vincentfusco/tt06_555/docs/info.md

<!---

This file is used to generate your project datasheet. Please fill in the information below and delete any unused
sections.

You can also include images in this folder and reference them in the markdown. Each image must be less than
512 kb in size, and the combined size of all images must be less than 1 MB.
-->

## How it works

It duplicates the functionality of a 555 timer. Try configuring it in the "astable" configuration using external resistors and capacitors.

## How to test

Find a 555 timer datasheet and attempt some of the suggested circuits. 

Connect pins to a breadboard with jumper wire. 

Construct circuit shown in Figure 7-5 at: https://www.ti.com/lit/ds/symlink/lmc555.pdf?ts=1711738020668.

Test 2:

Duplicate circuit in Figure 6-2 at: https://www.ti.com/lit/ds/symlink/lmc555.pdf?ts=1711738020668. Compare resulting maximum frequency. The CMOS-based TI 555-Timer has a maximum frequency of 3.0MHz. Compare.

## External hardware

1. Wires for breadboard.
2. Through-hole resistors and capacitors of various values, LEDs, etc.
3. Breadboard.
4. Oscilloscope (for maximum frequency test)
