vincentfusco/tt06_555/docs/COMP_P.md

## Comparator Design Notes ##

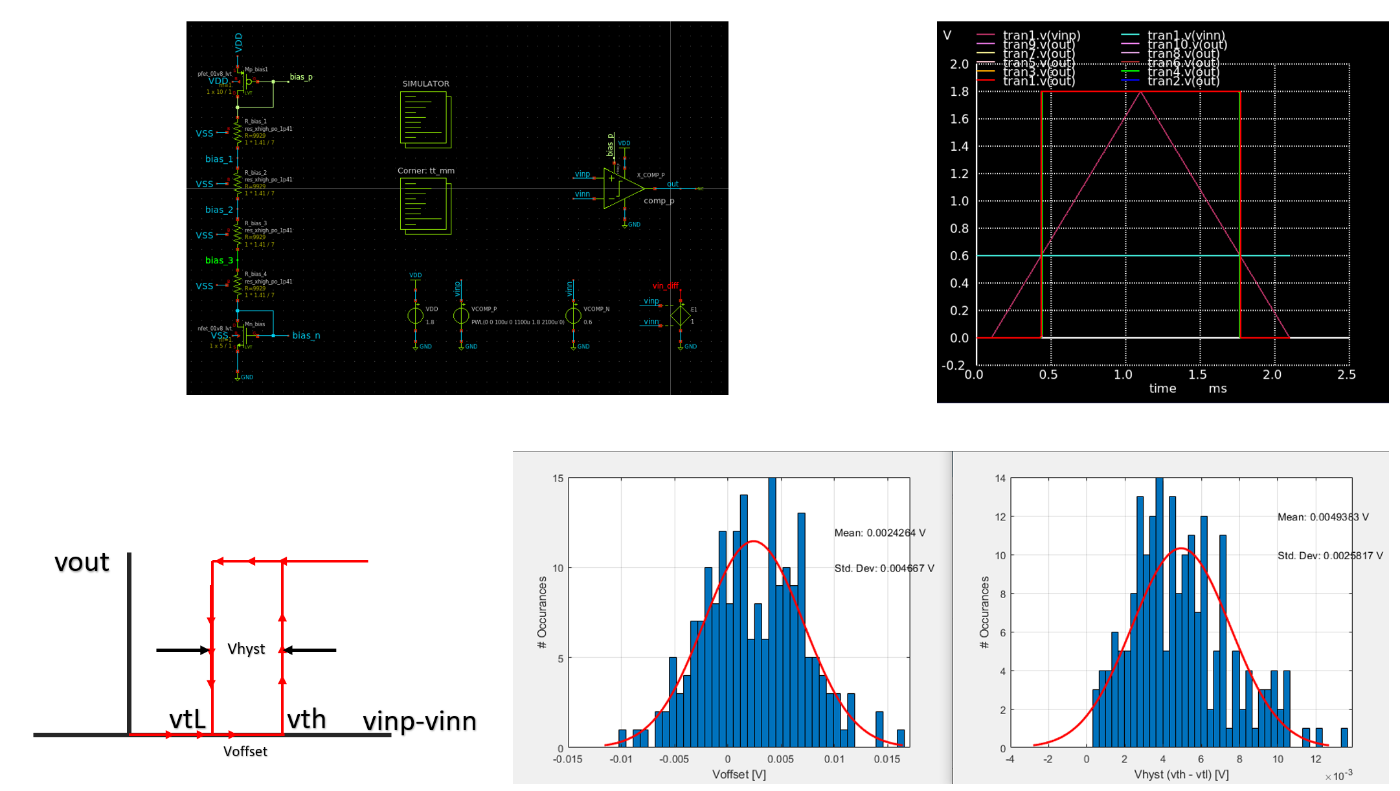
[picture p10: docs/comp_p_simulations.PNG]
Comparator Offset Simulation
