vincentfusco/tt06_555/docs/555_datasheet_fig7p5.PNG

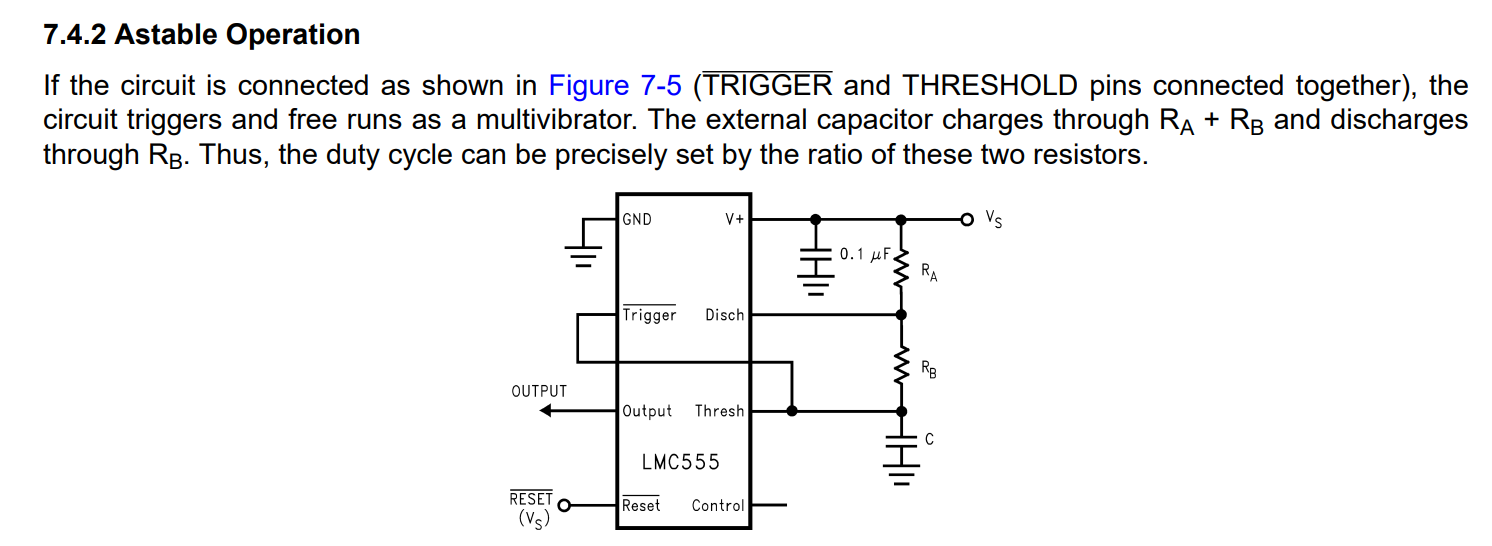
docs/555_datasheet_fig7p5.PNG
