vincentfusco/tt06_555/docs/braying_board_mule.png

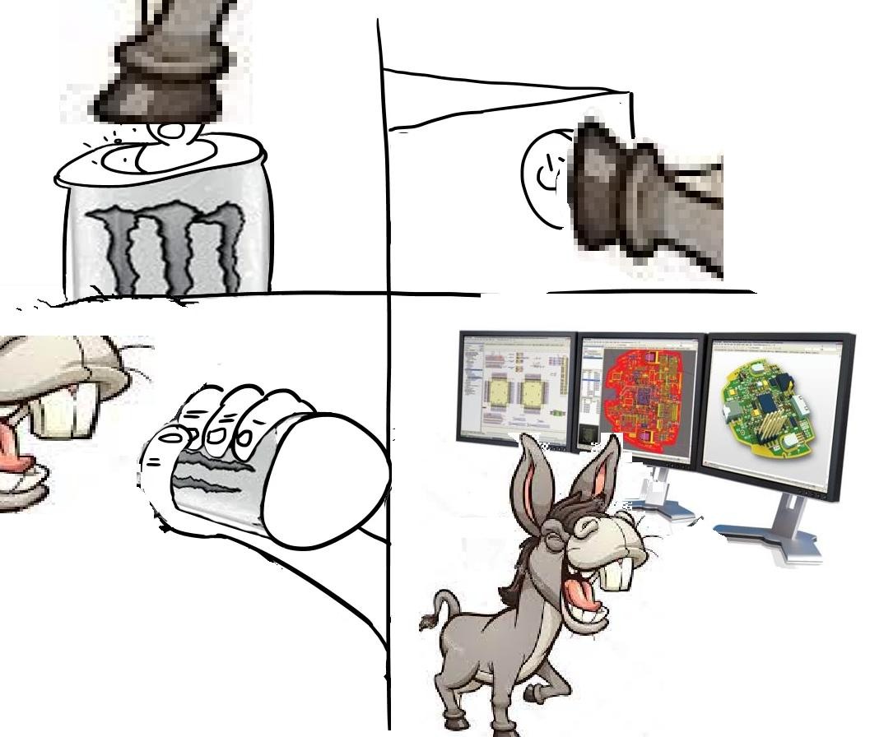
docs/braying_board_mule.png
