vincentfusco/tt06_555/docs/gibson.PNG

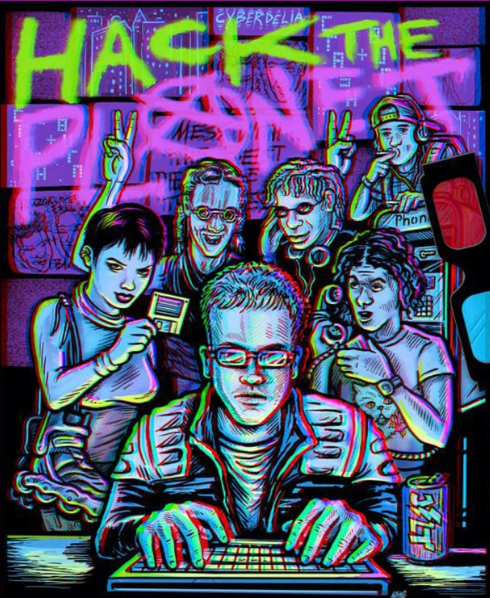
docs/gibson.PNG
