vincentfusco/tt06_555/mag/artwork/art.png

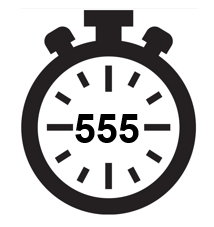
mag/artwork/art.png
