vincentfusco/tt06_555/docs/timer_core_mc_results.png

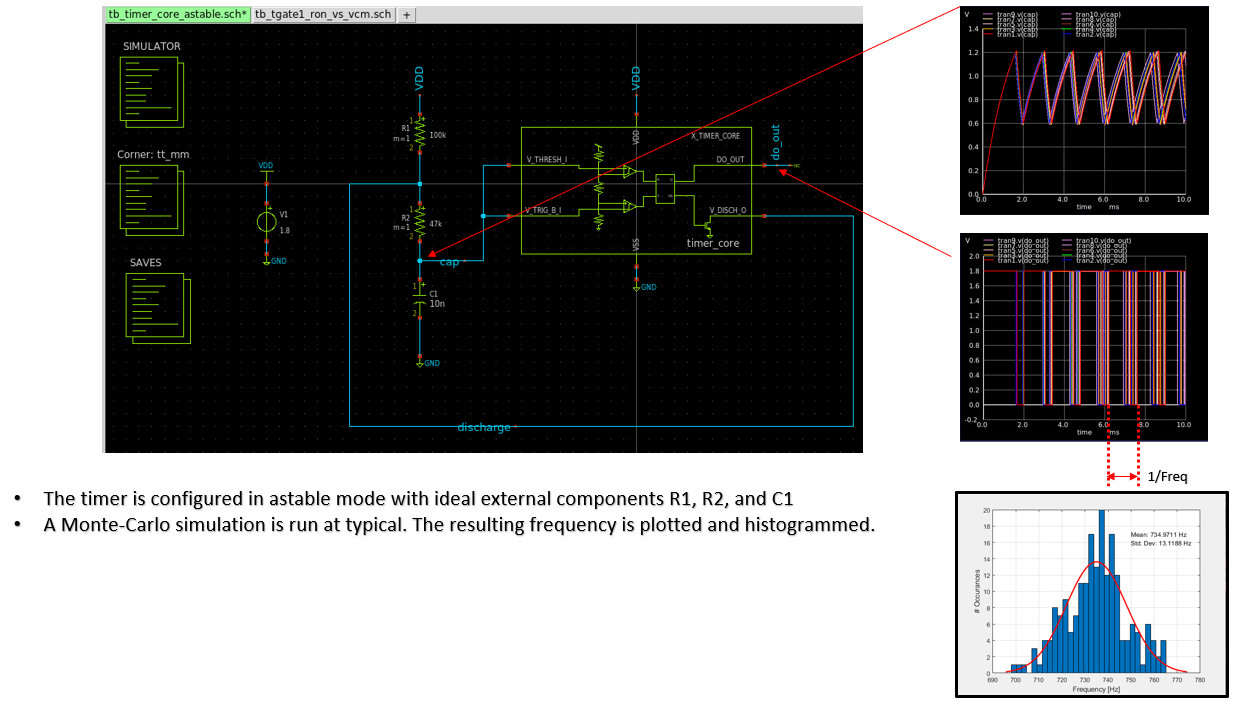
docs/timer_core_mc_results.png
