vincentfusco/tt06_555/xsch/ip/top/tt_um_vaf_555_timer/tt_um_vaf_555_timer_pex.spice

* NGSPICE file created from tt_um_vaf_555_timer_pex_flat.ext - technology: sky130A





.subckt tt_um_vaf_555_timer_pex clk ena rst_n ua[0] ua[1] ua[2] ua[3] ua[4] ua[5] ua[6] ua[7] ui_in[0] ui_in[1] ui_in[2] ui_in[3]
+ ui_in[4] ui_in[5] ui_in[6] ui_in[7] uio_in[0] uio_in[1] uio_in[2] uio_in[3] uio_in[4] uio_in[5] uio_in[6] uio_in[7] uio_oe[0] uio_oe[1]
+ uio_oe[2] uio_oe[3] uio_oe[4] uio_oe[5] uio_oe[6] uio_oe[7] uio_out[0] uio_out[1] uio_out[2] uio_out[3] uio_out[4] uio_out[5] uio_out[6]
+ uio_out[7] uo_out[0] uo_out[1] uo_out[2] uo_out[3] uo_out[4] uo_out[5] uo_out[6] uo_out[7] VPWR VGND

X0 X_TIMER.out_inv_pex3 uo_out[0].t4 VPWR.t9 VPWR.t8 sky130_fd_pr__pfet_01v8 ad=0.29 pd=2.58 as=0.29 ps=2.58 w=1 l=0.15
X1 X_TIMER.X_COMP_P_BOTTOM.latch_right.t6 X_TIMER.X_COMP_P_BOTTOM.latch_right.t5 VGND.t32 VGND.t31 sky130_fd_pr__nfet_01v8_lvt ad=1.16 pd=8.58 as=1.16 ps=8.58 w=4 l=1
X2 X_TIMER.X_COMP_P_TOP.latch_right.t6 ua[0].t0 X_TIMER.X_COMP_P_TOP.tail.t8 VPWR.t12 sky130_fd_pr__pfet_01v8_lvt ad=2.89855 pd=20.57 as=2.89855 ps=20.57 w=9.995 l=0.35
X3 X_TIMER.X_COMP_P_TOP.tail.t4 X_TIMER.bias_p VPWR.t38 VPWR.t37 sky130_fd_pr__pfet_01v8_lvt ad=2.9 pd=20.58 as=2.9 ps=20.58 w=10 l=1
X4 VPWR.t36 X_TIMER.bias_p X_TIMER.X_COMP_P_BOTTOM.tail.t8 VPWR.t35 sky130_fd_pr__pfet_01v8_lvt ad=2.9 pd=20.58 as=2.9 ps=20.58 w=10 l=1
X5 X_TIMER.qb_sr X_TIMER.X_SR_LATCH.IN_S.t2 VGND.t42 VGND.t7 sky130_fd_pr__nfet_01v8 ad=0.29 pd=2.58 as=0.145 ps=1.29 w=1 l=0.15
X6 X_TIMER.out_inv_pex3 uo_out[0].t5 VGND.t4 VGND.t0 sky130_fd_pr__nfet_01v8 ad=0.29 pd=2.58 as=0.29 ps=2.58 w=1 l=0.15
X7 X_TIMER.X_SR_LATCH.IN_S.t1 X_TIMER.X_COMP_P_BOTTOM.latch_right.t7 VGND.t30 VGND.t28 sky130_fd_pr__nfet_01v8_lvt ad=1.45 pd=10.58 as=1.45 ps=10.58 w=5 l=1
X8 X_TIMER.X_SR_LATCH.IN_R.t0 X_TIMER.X_COMP_P_TOP.out_left.t3 VPWR.t22 VPWR.t21 sky130_fd_pr__pfet_01v8_lvt ad=2.32 pd=16.58 as=2.32 ps=16.58 w=8 l=1
X9 VGND X_TIMER.v0p6 VGND.t39 sky130_fd_pr__res_xhigh_po_1p41 l=7
X10 X_TIMER.X_SR_LATCH.X_NOR_BOTTOM.IN_B ui_in[0].t0 VPWR.t24 VPWR.t23 sky130_fd_pr__pfet_01v8 ad=0.58 pd=4.58 as=0.29 ps=2.29 w=2 l=0.15
X11 X_TIMER.out_inv_pex3 uo_out[0].t6 VGND.t3 VGND.t0 sky130_fd_pr__nfet_01v8 ad=0.29 pd=2.58 as=0.29 ps=2.58 w=1 l=0.15
X12 X_TIMER.bias_1 X_TIMER.bias_2 VGND.t33 sky130_fd_pr__res_xhigh_po_1p41 l=7
X13 X_TIMER.X_COMP_P_BOTTOM.tail.t6 ua[1].t0 X_TIMER.X_COMP_P_BOTTOM.latch_left.t6 VPWR.t1 sky130_fd_pr__pfet_01v8_lvt ad=2.89855 pd=20.57 as=2.89855 ps=20.57 w=9.995 l=0.35
X14 X_TIMER.out_inv_pex1 X_TIMER.q_sr VPWR.t18 VPWR.t17 sky130_fd_pr__pfet_01v8 ad=0.29 pd=2.58 as=0.29 ps=2.58 w=1 l=0.15
X15 X_TIMER.X_COMP_P_TOP.latch_right.t5 ua[0].t1 X_TIMER.X_COMP_P_TOP.tail.t6 VPWR.t11 sky130_fd_pr__pfet_01v8_lvt ad=2.89855 pd=20.57 as=2.89855 ps=20.57 w=9.995 l=0.35
X16 VPWR.t26 X_TIMER.X_COMP_P_BOTTOM.out_left.t3 X_TIMER.X_SR_LATCH.IN_S.t0 VPWR.t25 sky130_fd_pr__pfet_01v8_lvt ad=2.32 pd=16.58 as=2.32 ps=16.58 w=8 l=1
X17 X_TIMER.out_inv_pex1 X_TIMER.q_sr VGND.t15 VGND.t0 sky130_fd_pr__nfet_01v8 ad=0.29 pd=2.58 as=0.29 ps=2.58 w=1 l=0.15
X18 X_TIMER.X_COMP_P_BOTTOM.latch_left.t0 X_TIMER.X_COMP_P_BOTTOM.latch_right.t8 VGND.t29 VGND.t28 sky130_fd_pr__nfet_01v8_lvt ad=1.45 pd=10.58 as=1.45 ps=10.58 w=5 l=1
X19 VGND.t13 X_TIMER.X_COMP_P_TOP.latch_left.t7 X_TIMER.X_COMP_P_TOP.out_left.t2 VGND.t9 sky130_fd_pr__nfet_01v8_lvt ad=1.45 pd=10.58 as=1.45 ps=10.58 w=5 l=1
X20 X_TIMER.X_COMP_P_TOP.latch_left.t3 X_TIMER.v1p2 X_TIMER.X_COMP_P_TOP.tail.t1 VPWR.t11 sky130_fd_pr__pfet_01v8_lvt ad=2.89855 pd=20.57 as=2.89855 ps=20.57 w=9.995 l=0.35
X21 X_TIMER.bias_p X_TIMER.bias_p VPWR.t34 VPWR.t33 sky130_fd_pr__pfet_01v8_lvt ad=2.9 pd=20.58 as=2.9 ps=20.58 w=10 l=1
X22 X_TIMER.X_COMP_P_BOTTOM.tail.t7 ua[1].t1 X_TIMER.X_COMP_P_BOTTOM.latch_left.t5 VPWR.t1 sky130_fd_pr__pfet_01v8_lvt ad=2.89855 pd=20.57 as=2.89855 ps=20.57 w=9.995 l=0.35
X23 X_TIMER.X_COMP_P_TOP.latch_left.t2 X_TIMER.v1p2 X_TIMER.X_COMP_P_TOP.tail.t0 VPWR.t12 sky130_fd_pr__pfet_01v8_lvt ad=2.89855 pd=20.57 as=2.89855 ps=20.57 w=9.995 l=0.35
X24 X_TIMER.out_inv_pex3 uo_out[0].t7 VPWR.t7 VPWR.t6 sky130_fd_pr__pfet_01v8 ad=0.29 pd=2.58 as=0.29 ps=2.58 w=1 l=0.15
X25 X_TIMER.v1p2 X_TIMER.v0p6 VGND.t39 sky130_fd_pr__res_xhigh_po_1p41 l=7
X26 X_TIMER.X_COMP_P_TOP.latch_left.t1 X_TIMER.v1p2 X_TIMER.X_COMP_P_TOP.tail.t3 VPWR.t11 sky130_fd_pr__pfet_01v8_lvt ad=2.89855 pd=20.57 as=2.89855 ps=20.57 w=9.995 l=0.35
X27 X_TIMER.X_SR_LATCH.nand_pex_0.IN_A X_TIMER.X_SR_LATCH.IN_R.t2 VPWR.t14 VPWR.t13 sky130_fd_pr__pfet_01v8 ad=0.29 pd=2.58 as=0.29 ps=2.58 w=1 l=0.15
X28 uo_out[0].t1 X_TIMER.out_inv_pex1 VPWR.t32 VPWR.t31 sky130_fd_pr__pfet_01v8 ad=0.29 pd=2.58 as=0.29 ps=2.58 w=1 l=0.15
X29 X_TIMER.out_inv_pex3 uo_out[0].t8 VPWR.t5 VPWR.t4 sky130_fd_pr__pfet_01v8 ad=0.29 pd=2.58 as=0.29 ps=2.58 w=1 l=0.15
X30 X_TIMER.out_inv_pex3 uo_out[0].t9 VGND.t2 VGND.t0 sky130_fd_pr__nfet_01v8 ad=0.29 pd=2.58 as=0.29 ps=2.58 w=1 l=0.15
X31 X_TIMER.X_COMP_P_BOTTOM.tail.t3 X_TIMER.v0p6 X_TIMER.X_COMP_P_BOTTOM.latch_right.t3 VPWR.t1 sky130_fd_pr__pfet_01v8_lvt ad=2.89855 pd=20.57 as=2.89855 ps=20.57 w=9.995 l=0.35
X32 uo_out[0].t2 X_TIMER.out_inv_pex1 VPWR.t30 VPWR.t29 sky130_fd_pr__pfet_01v8 ad=0.29 pd=2.58 as=0.29 ps=2.58 w=1 l=0.15
X33 VGND.t44 X_TIMER.bias_n X_TIMER.bias_n VGND.t43 sky130_fd_pr__nfet_01v8_lvt ad=1.45 pd=10.58 as=1.45 ps=10.58 w=5 l=1
X34 X_TIMER.q_sr X_TIMER.X_SR_LATCH.X_NOR_BOTTOM.IN_B a_1723_2994# VPWR.t10 sky130_fd_pr__pfet_01v8 ad=0.58 pd=4.58 as=0.29 ps=2.29 w=2 l=0.15
X35 X_TIMER.X_COMP_P_BOTTOM.tail.t2 X_TIMER.v0p6 X_TIMER.X_COMP_P_BOTTOM.latch_right.t2 VPWR.t0 sky130_fd_pr__pfet_01v8_lvt ad=2.89855 pd=20.57 as=2.89855 ps=20.57 w=9.995 l=0.35
X36 X_TIMER.X_SR_LATCH.X_NOR_BOTTOM.IN_B ui_in[0].t1 X_TIMER.X_SR_LATCH.nand_pex_0.drain_mna VGND.t7 sky130_fd_pr__nfet_01v8 ad=0.29 pd=2.58 as=0.145 ps=1.29 w=1 l=0.15
X37 VGND.t49 X_TIMER.qb_sr X_TIMER.q_sr VGND.t7 sky130_fd_pr__nfet_01v8 ad=0.145 pd=1.29 as=0.29 ps=2.58 w=1 l=0.15
X38 uo_out[0].t3 X_TIMER.out_inv_pex1 VGND.t46 VGND.t0 sky130_fd_pr__nfet_01v8 ad=0.29 pd=2.58 as=0.29 ps=2.58 w=1 l=0.15
X39 X_TIMER.out_inv_pex3 uo_out[0].t10 VGND.t1 VGND.t0 sky130_fd_pr__nfet_01v8 ad=0.29 pd=2.58 as=0.29 ps=2.58 w=1 l=0.15
X40 X_TIMER.X_COMP_P_BOTTOM.tail.t1 X_TIMER.v0p6 X_TIMER.X_COMP_P_BOTTOM.latch_right.t1 VPWR.t1 sky130_fd_pr__pfet_01v8_lvt ad=2.89855 pd=20.57 as=2.89855 ps=20.57 w=9.995 l=0.35
X41 uo_out[0].t0 X_TIMER.out_inv_pex1 VGND.t45 VGND.t0 sky130_fd_pr__nfet_01v8 ad=0.29 pd=2.58 as=0.29 ps=2.58 w=1 l=0.15
X42 VGND.t50 X_TIMER.X_COMP_P_TOP.latch_right.t7 X_TIMER.X_SR_LATCH.IN_R.t1 VGND.t34 sky130_fd_pr__nfet_01v8_lvt ad=1.45 pd=10.58 as=1.45 ps=10.58 w=5 l=1
X43 VGND.t12 X_TIMER.X_COMP_P_TOP.latch_left.t4 X_TIMER.X_COMP_P_TOP.latch_left.t5 VGND.t11 sky130_fd_pr__nfet_01v8_lvt ad=1.16 pd=8.58 as=1.16 ps=8.58 w=4 l=1
X44 ua[2].t4 X_TIMER.out_inv_pex3 VGND.t25 VGND.t24 sky130_fd_pr__nfet_01v8_lvt ad=1.45 pd=10.29 as=2.9 ps=20.58 w=10 l=0.35
X45 X_TIMER.qb_sr X_TIMER.X_SR_LATCH.IN_S.t3 a_1347_2994# VPWR.t27 sky130_fd_pr__pfet_01v8 ad=0.58 pd=4.58 as=0.29 ps=2.29 w=2 l=0.15
X46 X_TIMER.X_COMP_P_BOTTOM.tail.t0 X_TIMER.v0p6 X_TIMER.X_COMP_P_BOTTOM.latch_right.t0 VPWR.t0 sky130_fd_pr__pfet_01v8_lvt ad=2.89855 pd=20.57 as=2.89855 ps=20.57 w=9.995 l=0.35
X47 VGND.t14 X_TIMER.q_sr X_TIMER.qb_sr VGND.t7 sky130_fd_pr__nfet_01v8 ad=0.145 pd=1.29 as=0.29 ps=2.58 w=1 l=0.15
X48 X_TIMER.X_COMP_P_TOP.latch_right.t4 ua[0].t2 X_TIMER.X_COMP_P_TOP.tail.t5 VPWR.t11 sky130_fd_pr__pfet_01v8_lvt ad=2.89855 pd=20.57 as=2.89855 ps=20.57 w=9.995 l=0.35
X49 VGND.t23 X_TIMER.out_inv_pex3 ua[2].t3 VGND.t22 sky130_fd_pr__nfet_01v8_lvt ad=1.45 pd=10.29 as=1.45 ps=10.29 w=10 l=0.35
X50 VPWR.t20 X_TIMER.X_COMP_P_BOTTOM.out_left.t0 X_TIMER.X_COMP_P_BOTTOM.out_left.t1 VPWR.t19 sky130_fd_pr__pfet_01v8_lvt ad=2.32 pd=16.58 as=2.32 ps=16.58 w=8 l=1
X51 VPWR.t42 X_TIMER.X_SR_LATCH.nand_pex_0.IN_A X_TIMER.X_SR_LATCH.X_NOR_BOTTOM.IN_B VPWR.t41 sky130_fd_pr__pfet_01v8 ad=0.29 pd=2.29 as=0.58 ps=4.58 w=2 l=0.15
X52 VGND.t21 X_TIMER.out_inv_pex3 ua[2].t2 VGND.t20 sky130_fd_pr__nfet_01v8_lvt ad=1.45 pd=10.29 as=1.45 ps=10.29 w=10 l=0.35
X53 X_TIMER.X_COMP_P_BOTTOM.tail.t4 ua[1].t2 X_TIMER.X_COMP_P_BOTTOM.latch_left.t4 VPWR.t0 sky130_fd_pr__pfet_01v8_lvt ad=2.89855 pd=20.57 as=2.89855 ps=20.57 w=9.995 l=0.35
X54 X_TIMER.bias_3 X_TIMER.bias_2 VGND.t33 sky130_fd_pr__res_xhigh_po_1p41 l=7
X55 X_TIMER.bias_1 X_TIMER.bias_p VGND.t33 sky130_fd_pr__res_xhigh_po_1p41 l=7
X56 ua[2].t1 X_TIMER.out_inv_pex3 VGND.t19 VGND.t18 sky130_fd_pr__nfet_01v8_lvt ad=2.9 pd=20.58 as=1.45 ps=10.29 w=10 l=0.35
X57 ua[2].t0 X_TIMER.out_inv_pex3 VGND.t17 VGND.t16 sky130_fd_pr__nfet_01v8_lvt ad=1.45 pd=10.29 as=1.45 ps=10.29 w=10 l=0.35
X58 X_TIMER.X_COMP_P_BOTTOM.tail.t5 ua[1].t3 X_TIMER.X_COMP_P_BOTTOM.latch_left.t3 VPWR.t0 sky130_fd_pr__pfet_01v8_lvt ad=2.89855 pd=20.57 as=2.89855 ps=20.57 w=9.995 l=0.35
X59 X_TIMER.X_COMP_P_TOP.out_left.t1 X_TIMER.X_COMP_P_TOP.out_left.t0 VPWR.t40 VPWR.t39 sky130_fd_pr__pfet_01v8_lvt ad=2.32 pd=16.58 as=2.32 ps=16.58 w=8 l=1
X60 X_TIMER.X_COMP_P_BOTTOM.latch_left.t2 X_TIMER.X_COMP_P_BOTTOM.latch_left.t1 VGND.t38 VGND.t37 sky130_fd_pr__nfet_01v8_lvt ad=1.16 pd=8.58 as=1.16 ps=8.58 w=4 l=1
X61 X_TIMER.X_SR_LATCH.nand_pex_0.IN_A X_TIMER.X_SR_LATCH.IN_R.t3 VGND.t47 VGND.t7 sky130_fd_pr__nfet_01v8 ad=0.29 pd=2.58 as=0.29 ps=2.58 w=1 l=0.15
X62 X_TIMER.v1p2 VPWR VGND.t39 sky130_fd_pr__res_xhigh_po_1p41 l=7
X63 X_TIMER.bias_3 X_TIMER.bias_n VGND.t33 sky130_fd_pr__res_xhigh_po_1p41 l=7
X64 VGND.t10 X_TIMER.X_COMP_P_TOP.latch_left.t8 X_TIMER.X_COMP_P_TOP.latch_right.t0 VGND.t9 sky130_fd_pr__nfet_01v8_lvt ad=1.45 pd=10.58 as=1.45 ps=10.58 w=5 l=1
X65 VGND.t27 X_TIMER.X_COMP_P_TOP.latch_right.t1 X_TIMER.X_COMP_P_TOP.latch_right.t2 VGND.t26 sky130_fd_pr__nfet_01v8_lvt ad=1.16 pd=8.58 as=1.16 ps=8.58 w=4 l=1
X66 a_1723_2994# X_TIMER.qb_sr VPWR.t44 VPWR.t43 sky130_fd_pr__pfet_01v8 ad=0.29 pd=2.29 as=0.58 ps=4.58 w=2 l=0.15
X67 X_TIMER.X_SR_LATCH.nand_pex_0.drain_mna X_TIMER.X_SR_LATCH.nand_pex_0.IN_A VGND.t48 VGND.t7 sky130_fd_pr__nfet_01v8 ad=0.145 pd=1.29 as=0.29 ps=2.58 w=1 l=0.15
X68 X_TIMER.X_COMP_P_BOTTOM.out_left.t2 X_TIMER.X_COMP_P_BOTTOM.latch_left.t7 VGND.t36 VGND.t5 sky130_fd_pr__nfet_01v8_lvt ad=1.45 pd=10.58 as=1.45 ps=10.58 w=5 l=1
X69 X_TIMER.X_COMP_P_TOP.latch_left.t0 X_TIMER.v1p2 X_TIMER.X_COMP_P_TOP.tail.t2 VPWR.t12 sky130_fd_pr__pfet_01v8_lvt ad=2.89855 pd=20.57 as=2.89855 ps=20.57 w=9.995 l=0.35
X70 a_1347_2994# X_TIMER.q_sr VPWR.t16 VPWR.t15 sky130_fd_pr__pfet_01v8 ad=0.29 pd=2.29 as=0.58 ps=4.58 w=2 l=0.15
X71 X_TIMER.q_sr X_TIMER.X_SR_LATCH.X_NOR_BOTTOM.IN_B VGND.t8 VGND.t7 sky130_fd_pr__nfet_01v8 ad=0.29 pd=2.58 as=0.145 ps=1.29 w=1 l=0.15
X72 VGND.t35 X_TIMER.X_COMP_P_TOP.latch_right.t8 X_TIMER.X_COMP_P_TOP.latch_left.t6 VGND.t34 sky130_fd_pr__nfet_01v8_lvt ad=1.45 pd=10.58 as=1.45 ps=10.58 w=5 l=1
X73 X_TIMER.X_COMP_P_TOP.latch_right.t3 ua[0].t3 X_TIMER.X_COMP_P_TOP.tail.t7 VPWR.t12 sky130_fd_pr__pfet_01v8_lvt ad=2.89855 pd=20.57 as=2.89855 ps=20.57 w=9.995 l=0.35
X74 X_TIMER.out_inv_pex3 uo_out[0].t11 VPWR.t3 VPWR.t2 sky130_fd_pr__pfet_01v8 ad=0.29 pd=2.58 as=0.29 ps=2.58 w=1 l=0.15
X75 X_TIMER.X_COMP_P_BOTTOM.latch_right.t4 X_TIMER.X_COMP_P_BOTTOM.latch_left.t8 VGND.t6 VGND.t5 sky130_fd_pr__nfet_01v8_lvt ad=1.45 pd=10.58 as=1.45 ps=10.58 w=5 l=1
R0 uo_out[0].n6 uo_out[0].t5 411.07
R1 uo_out[0].n5 uo_out[0].t9 411.07
R2 uo_out[0].n4 uo_out[0].t10 411.07
R3 uo_out[0].n3 uo_out[0].t6 411.07
R4 uo_out[0].n6 uo_out[0].t11 400.375
R5 uo_out[0].n5 uo_out[0].t7 400.375
R6 uo_out[0].n4 uo_out[0].t8 400.375
R7 uo_out[0].n2 uo_out[0].t4 395.873
R8 uo_out[0].n1 uo_out[0].t1 228.959
R9 uo_out[0].n0 uo_out[0].t2 228.959
R10 uo_out[0].n1 uo_out[0].t3 84.8864
R11 uo_out[0].n0 uo_out[0].t0 84.8864
R12 uo_out[0].n7 uo_out[0] 39.2126
R13 uo_out[0] uo_out[0].n6 28.1147
R14 uo_out[0].n3 uo_out[0].n2 4.50234
R15 uo_out[0].n1 uo_out[0] 0.8755
R16 uo_out[0].n2 uo_out[0] 0.800132
R17 uo_out[0] uo_out[0].n3 0.382853
R18 uo_out[0] uo_out[0].n4 0.382853
R19 uo_out[0] uo_out[0].n5 0.382853
R20 uo_out[0].n3 uo_out[0] 0.378389
R21 uo_out[0].n4 uo_out[0] 0.378389
R22 uo_out[0].n5 uo_out[0] 0.378389
R23 uo_out[0].n6 uo_out[0] 0.378389
R24 uo_out[0].n7 uo_out[0] 0.120692
R25 uo_out[0] uo_out[0].n7 0.116241
R26 uo_out[0] uo_out[0].n1 0.0924118
R27 uo_out[0] uo_out[0].n0 0.0924118
R28 VPWR.n92 VPWR.n41 5809.41
R29 VPWR.n92 VPWR.n91 5809.41
R30 VPWR.n100 VPWR.n36 5809.41
R31 VPWR.n100 VPWR.n99 5809.41
R32 VPWR.n87 VPWR.n43 5784.71
R33 VPWR.n89 VPWR.n43 5784.71
R34 VPWR.n69 VPWR.n67 5784.71
R35 VPWR.n69 VPWR.n68 5784.71
R36 VPWR.n121 VPWR.n117 4912.94
R37 VPWR.n118 VPWR.n115 4912.94
R38 VPWR.n59 VPWR.n38 4912.94
R39 VPWR.n96 VPWR.n38 4912.94
R40 VPWR.n59 VPWR.n23 4912.94
R41 VPWR.n96 VPWR.n23 4912.94
R42 VPWR.n153 VPWR.n6 4912.94
R43 VPWR.n152 VPWR.n6 4912.94
R44 VPWR.n152 VPWR.n5 4912.94
R45 VPWR.n153 VPWR.n5 4912.94
R46 VPWR.n104 VPWR.n32 4208.75
R47 VPWR.n108 VPWR.n107 4207.06
R48 VPWR.n75 VPWR.n65 4207.06
R49 VPWR.n78 VPWR.n57 4205.22
R50 VPWR.n87 VPWR.n47 4020
R51 VPWR.n90 VPWR.n89 4020
R52 VPWR.n67 VPWR.n11 4020
R53 VPWR.n68 VPWR.n12 4020
R54 VPWR.n47 VPWR.n41 3998.82
R55 VPWR.n91 VPWR.n90 3998.82
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
R539 VGND.n38 VGND.n21 1373.21
R540 VGND.n256 VGND.n49 1351.14
R541 VGND.n138 VGND.n94 1309.47
R542 VGND.n148 VGND.n93 1309.47
R543 VGND.n93 VGND.n79 1309.47
R544 VGND.n154 VGND.n80 1309.47
R545 VGND.n155 VGND.n85 1309.47
R546 VGND.n155 VGND.n154 1309.47
R547 VGND.n149 VGND.n84 1309.47
R548 VGND.n149 VGND.n148 1309.47
R549 VGND.n142 VGND.n97 1309.47
R550 VGND.n142 VGND.n94 1309.47
R551 VGND.n13 VGND.n6 1309.47
R552 VGND.n13 VGND.n11 1309.47
R553 VGND.n124 VGND.n106 1309.47
R554 VGND.n12 VGND.n7 1309.47
R555 VGND.n126 VGND.n106 1309.47
R556 VGND.n126 VGND.n107 1309.47
R557 VGND.n111 VGND.n11 1309.47
R558 VGND.n112 VGND.n111 1309.47
R559 VGND.n294 VGND.n12 1309.47
R560 VGND.n294 VGND.n293 1309.47
R561 VGND.t28 VGND.n81 1288.91
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
