vincentfusco/tt06_555/(commit log)

2024-03-19 First snapshot. Rough hierarchy in place, schematics, and testbench showing life.
    [cmdiffamp.sch, comp_n.sch, comp_p.sch, inv.sch, nor.sch, sr_latch.sch, tb_inv_tran.sch, tb_timer_core_astable.sch]
2024-03-23 Some new schematic and layout cells. Nothing complete.
    [comp_n.sch, comp_n_simple.sch, comp_p.sch, inv.sch, ngspice_tut1.sch, ngspice_tut2.sch, ngspice_tut2_mc.sch, ngspice_tut3.sch]
2024-03-23 Updated timer testbench for monte carlo
    [cmdiffamp.sch, tb_timer_core_astable.sch]
2024-03-27 Commit just for backup. Work in progress.
    [test.csv]
2024-03-29 comp_p is DRC and LVS clean. added some analysis scripts and new testbenches too.
    [tb_comp_p_dc_sweep.sch, tb_comp_p_tran_sweep.sch, tb_comp_p_tran_sweep_mc.sch]
2024-03-29 Added some floorplanning to timer top cell
    [sr_latch.sch, timer_core.sch]
2024-03-29 DRC and LVS clean nor and SR_latch
    [sr_latch.sch]
2024-03-29 Top level power routing and floorplanning partially completed no LVS. Syncing just for backup.
    [timer_core.sch]
2024-03-29 DRC and LVS clean at timer level. Just need to put in tiny-tapeout top cell
    [timer_core.sch]
2024-03-29 DRC LVS clean first GDS and LEF creation attempt.
    [tt_um_vaf_555_timer.sch]
2024-03-30 DRC and LVS fully pass. Unconnected pins added to top cell schematic for pin matching.
    [tt_um_vaf_555_timer.sch]
2024-03-30 DRC and LVS clean. PEX simulations match schematic. Ready to submit.
    [cmdiffamp.sch, comp_n.sch, comp_n_simple.sch, comp_p.sch, inv.sch, nor.sch, sr_latch.sch, tb_comp_p_dc_sweep.sch]
2024-03-31 DRC and LVS clean. PEX sim verified. Changed top-level pins. Added additional diginal input to allow async. reset.
    [nand.sch, sr_latch.sch, sr_latch_rb.sch, tb_timer_core_astable.sch, tb_timer_core_astable_mc.sch, tb_tt_um_vaf_555_timer_astable.sch, timer_core.sch, tt_um_vaf_555_timer.sch]
2024-04-03 Updated documentation.
    [tb_tt_um_vaf_555_timer_astable.sch]
